Dohuni01/keep-your-distance/Desktop/UWB/CLAUDE_CONTEXT.md

# CLAUDE_CONTEXT.md
_이 파일은 미래의 Claude 인스턴스가 이 프로젝트를 빠르게 파악하고
올바른 방향으로 작업할 수 있도록 작성된 컨텍스트 문서다._

---

## 프로젝트 한 줄 요약

공사현장에서 UWB(DW3000)로 작업자와 장비 간 거리를 측정해
3m 이내 접근 시 GPIO26으로 장비를 자동 정지시키는 안전 시스템.

---

## 절대 어기면 안 되는 원칙

### 1. GPIO26 안전 제어는 네트워크 독립

릴레이 제어 코드(`setRelay`, `processTagDistance`, `processNoRange`)는
WiFi, MQTT, 서버 상태를 참조하거나 대기하면 안 된다.
현재 구조: Core 1의 `taskUWB`가 릴레이를 단독 제어.
Core 0의 `taskNetwork`는 데이터를 읽기만 한다.

이 원칙을 깨는 코드는 어떤 이유로도 작성하지 않는다.

### 1-A. 안전은 빠르게, 복구는 신중하게 (비대칭)

위험 **진입**(릴레이 ON)은 최대한 빠른 신호로 판정한다 (raw 또는 median(3)).
위험 **이탈**(릴레이 OFF)은 디바운스된 신중한 신호로 판정한다 (median(5) + CONFIRM_OFF_COUNT).
긴 이동평균을 진입 판정에 쓰면 정지가 늦어진다 (리뷰 발견 C1).
필터는 멀티패스 스파이크에 강한 **median**을 쓴다. 평균은 스파이크에 끌려간다.

### 1-B. 이벤트 판정 권위는 앵커에 있다

"위험 진입/이탈" 이벤트의 진실 원천은 **앵커**다 (디바운스·교정된 값으로 실제 릴레이를 제어).
대시보드나 백엔드가 거리로 위험을 **재계산**하면 안 된다.
권위 체인: **앵커가 판정·타임스탬프 → 브로커 전송 → 백엔드 영속화 → 대시보드 표시.**

### 2. 공유 데이터는 단방향

`g_tagReports`, `g_relayState`, `g_reportTimestamp`는
Core 1(UWB)이 쓰고 Core 0(Network)이 읽는다.
Core 0이 이 변수들에 값을 쓰는 코드를 추가하면 안 된다.
접근 시 반드시 `portENTER_CRITICAL(&g_reportMux)` 사용.

### 3. GPS는 지도 표시 전용

GPS 데이터는 Anchor의 지도 위치 표시에만 쓴다.
안전 거리 측정은 UWB만 담당한다.
GPS 신호 유무가 릴레이 동작에 영향을 주면 안 된다.

### 4. 확장은 "근접(proximity)"으로, 안전 우선 (2026-06-23 확장성 리뷰)

실제 목표는 현장 규모(앵커 10~50 / 태그 50~100)지만, 이는 **사이트 전역 RTLS가 아니라
장비별 근접 감지**다. "이 장비 3m 안에 작업자?"만 답하면 되며 100명 추적은 불필요.

확장 시 지켜야 할 결정:
- **문제는 근접(proximity)으로 재정의** — 비용을 `전체A×전체T`가 아니라 `장비 × 근처 태그`로.
- **공존 순서: 공간재사용 → 2채널(ch5/9) → (측정이 강요할 때만) TDMA.** TDMA를 미리 만들지 말 것.
- **하이브리드 tag-initiated** — blink=발견, 근처 태그는 앵커가 능동 폴링(결정론적 안전).
  순수 tag-initiated(blink 거리 추정)는 NLOS/충돌 시 거짓안전 위험이라 안전 시스템에 부적합.
- **안전 vs 확장성 충돌 시 안전 우선.** 확장성은 영리한 프로토콜이 아니라 하드웨어(채널·앵커·작은 셀)로 되산다.
- **측정 우선**: 확장 코드 전에 테스트 A(충돌)/B(NLOS)/D(재사용거리)/E(채널분리)로 물리 한계부터 잰다.
  테스트 A 도구 = `tests/anchor_collision_test/` (프로덕션 무수정 별도 스케치).

---

## 핵심 설계 결정 및 이유

### FreeRTOS 이중 코어 분리
WiFi 재연결이나 MQTT 처리가 수백ms 블로킹될 수 있다.
`loop()`에 네트워크 코드를 섞으면 UWB 폴링이 멈춰 안전 공백이 생긴다.
이를 막기 위해 Core 1(UWB)과 Core 0(Network)을 완전히 분리했다.

### 라운드로빈 폴링
DW3000은 1:1 TWR 방식이라 동시에 여러 태그와 통신할 수 없다.
Anchor가 등록된 태그를 순서대로 하나씩 호출한다.
태그 4개 기준 전체 주기 = 600ms (150ms × 4).

### 히스테리시스 (3.00m 진입 / 3.20m 이탈)
20cm 간격으로 릴레이 채터링(빠른 ON/OFF 반복)을 방지한다.
또한 이탈 판정은 3회 연속이어야 한다 (CONFIRM_OFF_COUNT=3).

### `noRangeTick`에서 `outsideCount` 리셋 금지
신호가 끊겼을 때 outsideCount를 리셋하면,
신호 단절 중에 이탈 카운트가 누적되지 않아 릴레이가 영원히 ON으로 남는다.
`processNoRange`는 `outsideCount`를 건드리지 않는다.

### WDT를 `taskUWB` 내부에서 등록
`setup()`에서 `esp_task_wdt_add(NULL)`을 호출하면
`loop()`가 `vTaskDelete`로 삭제된 후 해당 태스크가 WDT를 리셋하지 않아
15초 후 재부팅된다.
WDT 등록은 `taskUWB` 첫 줄에서 수행한다.

### MQTT retain=true (relay, status)
대시보드가 뒤늦게 접속해도 마지막 릴레이 상태와 온라인 여부를
브로커로부터 즉시 받을 수 있다.
거리 데이터(range)는 실시간성이 중요하므로 retain=false.

### LWT (Last Will Testament)
Anchor가 비정상 종료(전원 차단, crash)되면
브로커가 자동으로 `uwb/anchor/{id}/status`에 `{"online":false}`를 발행한다.
대시보드가 Anchor 오프라인을 능동적으로 감지할 수 있다.

---

## 프레임 구조 (반드시 숙지)

```
인덱스:  0     1     2     3     4     5          6        7        8    9
값:    0x41  0x88  SEQ  0xCA  0xDE  ANCHOR_ID  TAG_ID  MSG_TYPE  0x00 0x00

MSG_TYPE: 0xE0 = poll (Anchor → Tag)
          0xE1 = response (Tag → Anchor)

response 추가 필드:
  [10-13] poll_rx_ts  (uint32, 4바이트)
  [14-17] resp_tx_ts  (uint32, 4바이트)
  총 18바이트
```

SEQ(인덱스 2)는 비교 전 0으로 마스킹.
Anchor는 ANCHOR_ID + TAG_ID + MSG_TYPE 세 필드를 동시에 검증한다.
Tag는 MSG_TYPE + TAG_ID 두 필드만 검증 (어느 Anchor든 수락).

---

## 파일별 역할

| 파일 | 역할 |
|---|---|
| `Anchor/ancher_v1/ancher_v1.ino` | Anchor 펌웨어. Phase A(C1·C2)·B(적응형 폴링) 반영 |
| `Tag/tag_v1/tag_v1.ino` | Tag 펌웨어. Phase A C2(RX 타임아웃) 반영 |
| `tests/anchor_collision_test/` | 테스트 A — 다중 앵커 충돌 측정 도구 (프로덕션 무수정 별도 스케치) |
| `PROJECT_STATUS.md` | 현재 구현 상태, 빌드 환경, 알려진 이슈, Scale-out 리뷰 |
| `ROADMAP.md` | 전체 단계별 계획 + Scale-out 전략 |
| `CLAUDE.md` | Arduino 빌드/플래시 명령, 핀 배열 등 |

---

## 현재 알려진 중요 결함 (2026-06-23 리뷰)

작업 전 반드시 인지할 것. 상세·우선순위는 ROADMAP.md / PROJECT_STATUS.md 참조.

| ID | 결함 | 위치 | 단계 |
|---|---|---|---|
| C1 | 5-샘플 이동평균 = 약 3초 탐지 지연 (정지가 늦음) | `ancher_v1.ino:122` | A |
| C2 | 태그 RX 타임아웃 없는 무한 스핀 → 앵커 부재 시 10초마다 리부트 | `tag_v1.ino:90-93` | A |
| C3 | 앵커 간 RF 조율 없음 → 다중 앵커 시 충돌 | 프로토콜 전반 | **N/A** (1앵커 고정) |
| C4 | 타임스탬프가 `millis()`(가동시간), epoch 아님 | 모든 MQTT payload | C |
| C5 | 안테나 딜레이 미교정 (±10~30cm) | `TX/RX_ANT_DLY 16385` | A |

C2 주의: PROJECT_STATUS의 "Tag WDT 리부트"는 "의도된 동작"으로 적혀 있었으나
실제로는 **수정 대상 결함**이다. 태그에 `dwt_setrxtimeout` + re-arm 루프를 넣어
앵커 부재를 정상 idle로 처리해야 한다.

## 현재 미구현 (다음 작업 대상 — 개정된 우선순위)

기존 "GPS → 백엔드 → 대시보드" 순서는 폐기.
**안전 정확성이 모니터링보다 먼저**라는 원칙으로 재배치:

1. ✅ **Phase A — 안전 정확성**: C1(비대칭 median) + C2(태그 RX 타임아웃) 코드 완료, C5 교정 SOP 주석화(실측 대기)
2. ✅ **Phase B — 적응형 폴링**: C3 N/A(1앵커 고정). `absentCount`/`pollSkip` dead-tag 슬로 폴링 구현 완료
3. **Phase C — 필드급 펌웨어 신뢰성**: NTP, ArduinoJson, clientId, 동적 태그, 이벤트 버퍼, TLS
4. **Phase D — 백엔드 + DB**: Postgres(마스터/이벤트) + Influx(시계열, retention), 인증, staleness
5. **Phase E — 대시보드 실연동**: `USE_MOCK=false`, staleness UI, STOP/RUN 우선
6. **Phase F — 측위/GPS**: 고정 장비는 측량 좌표, 방위는 PDOA/삼변측량 필요
7. **Phase G — 강화/법규**: 절전, OTA, 2단계 구역, PIPA(위치=개인정보)

---

## 주의사항

- `PubSubClient` 기본 최대 메시지 크기 = 256바이트. 현재 페이로드는 이 안에 들어옴
- `PubSubClient`는 **publish QoS0만** 지원. relay 전이도 fire-and-forget이므로
  소비자(백엔드/대시보드)는 retain 값 + timestamp + staleness로 진실을 판단해야 함 (전달 보장에 의존 금지)
- `taskNetwork` 스택 = 8192 (WiFi 내부 TLS 스택 고려). 줄이지 말 것
- 태그 등록은 현재 컴파일 타임 고정 (`TAG_IDS[]`). 동적 레지스트리는 Phase C
- 안테나 딜레이(16385)는 미교정 기본값. 실측 교정 전까지 거리 오차 ±10~30cm 예상 (Phase A 교정)
- `WIFI_SSID`, `WIFI_PASSWORD`, `MQTT_BROKER`는 `ancher_v1.ino` 상단 define에서 수정
- MQTT 현재 평문 1883. 운영 전 TLS(8883) 전환 (Phase C)
- payload `ts`는 현재 `millis()`(가동시간). epoch 아님 — 백엔드에서 수신 시각 별도 기록, Phase C에서 NTP 도입
- GPS(GPIO16/17) 연결 전 보드 변종 확인 — ESP32-WROVER는 해당 핀이 PSRAM과 충돌
- 시스템은 **거리만** 측정하고 방위(bearing)는 모름. 대시보드 태그 점 위치는 illustrative (방위는 PDOA/삼변측량 필요)
