Dohuni01/keep-your-distance/(commit log)

2026-03-14 Create Arduino
2026-06-23 Apply Phase A safety fixes and revise project docs
    Firmware (Phase A — safety correctness):
    - Anchor: replace 5-sample mean filter with asymmetric median filter.
    Enter danger uses median(3) for fast response; exit uses median(5)
    for spike-resistant recovery. Eliminates ~3 s detection lag (C1).
    - Anchor: document antenna-delay 2-point calibration SOP in code (C5).
    - Anchor: add comment explaining taskNetwork is intentionally excluded
    from panic WDT to preserve safety-core independence.
    - Tag: add dwt_setrxtimeout(150 ms) and include ALL_RX_TO in the wait
    condition. Tag now idles gracefully when anchor is absent instead of
    rebooting every 10 s (C2).
    Docs (architecture review 2026-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
    [ancher_v1.ino, tag_v1.ino]
2026-06-23 Phase B: adaptive dead-tag polling for 1-anchor 4-tag setup
    Hardware is fixed at 1 anchor + 4 tags (single relay channel, one
    crossing beam), so multi-anchor RF collision (C3) is not applicable.
    Phase B instead improves polling efficiency for absent tags:
    - Add SLOW_POLL_THRESHOLD (10) / SLOW_POLL_PERIOD (5) constants
    - Add absentCount + pollSkip fields to TagState
    - Add absent field to TagReport (exposed in MQTT payload)
    - processNoRange: when tag is absent and NOT in danger, increment
    absentCount; after threshold set pollSkip = SLOW_POLL_PERIOD-1
    so the tag is checked only 1-in-5 cycles instead of every cycle
    - processTagDistance: on any successful range, reset absentCount,
    pollSkip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
    [ancher_v1.ino]
2026-06-23 docs: mark Phase A/B complete, C3 N/A for 1-anchor hardware
    Update PROJECT_STATUS.md and CLAUDE_CONTEXT.md to reflect:
    - Phase A (C1 asymmetric median, C2 RX timeout) code complete
    - Phase B reframed: C3 not applicable (hardware fixed at 1 anchor +
    4 tags), adaptive dead-tag polling implemented and verified
    - Polling timing table updated with slow-poll thresholds and
    safety exception (danger tags are never slow-polled)
    - Next priority is Phase C (NTP, ArduinoJson, TLS, dynamic registry)
2026-06-23 Add Test A collision tool + document scale-out strategy
    Test A tooling (tests/anchor_collision_test/):
    - Standalone measurement sketch (production untouched). Same DW3000
    config / frame format / SS-TWR math as ancher_v1, but WiFi/MQTT/
    relay stripped for clean RF measurement, plus success/no-range/
    wrong-frame counters and periodic PER + CSV output.
    - README runbook: 1-vs-N anchor procedure, load sweep, collision
    judgment thresholds, recording sheet.
    - Verified compile on esp32:esp32 core 3.3.7 via IDE-bundled
    arduino-cli (flash 22% / RAM 6%).
    Docs:
    - ROADMAP: Phase A/B marked complete; new Scale-out strategy section
    (proximity reframe, coexistence order spatial-reuse->2ch->TDMA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
    [anchor_collision_test.ino]
2026-06-24 Fix ESP32 core 3.x compat + frame layout: ranging now works on hardware
    - Frame structure: 12-byte poll / 20-byte response with 'U'/'W' sync
    markers at [7][8] and MSG_TYPE at [9] (was [7]); both anchor and tag
    must match — mismatch was the root cause of persistent no-range
    - SPI speed: 16 MHz -> 7 MHz (matches Makerfabs examples, more stable)
    - dwt_softreset() added before dwt_initialise() on both devices
    - clearUwbStatus() / waitForUwbStatus() helpers replace inline busy-waits
    - Tag response delay: 800 us -> 1500 us (gives ESP32 time to prep frame)
    - Anchor RX window: 240 us delay / 3 ms timeout -> 500 us / 5 ms
    - WDT: esp_task_wdt_reconfigure() instead of init() (Arduino core 3.x
    p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
    [ancher_v1.ino, tag_v1.ino]
